darts/kEeB_UpGrAdE/media/useful_template.png

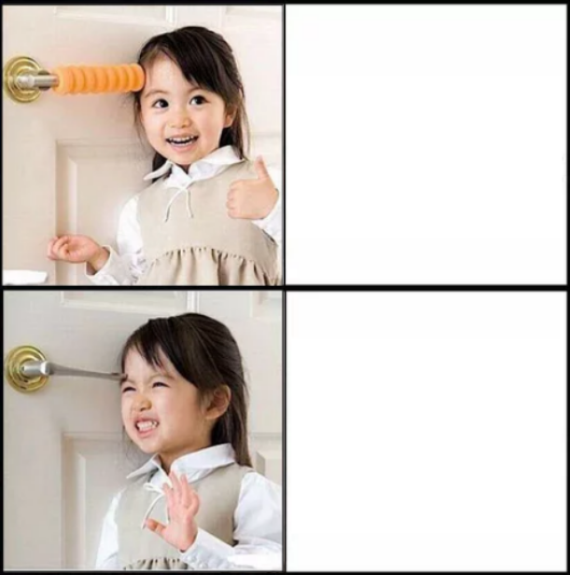
media/useful_template.png
