darts/kEeB_UpGrAdE/stl/kEeB_bOtToM.stl

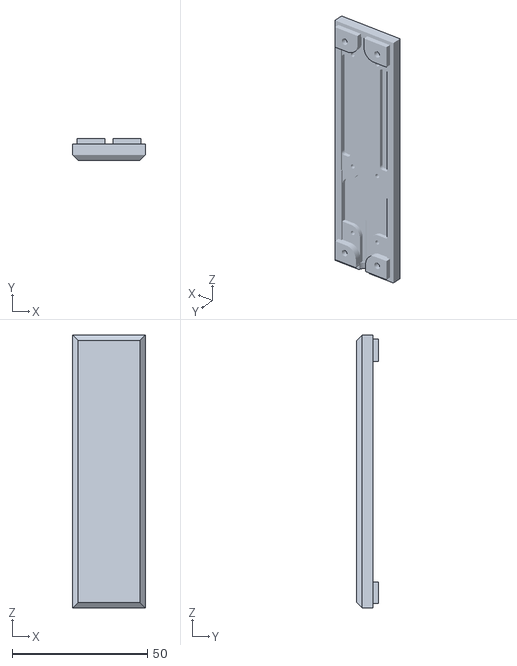
[picture p7: CAD file, 2023-09-17]
stl/kEeB_bOtToM.stl
27.0 x 8.00 x 101.0
