darts/kEeB_UpGrAdE/stl/kEeB_tOp.stl

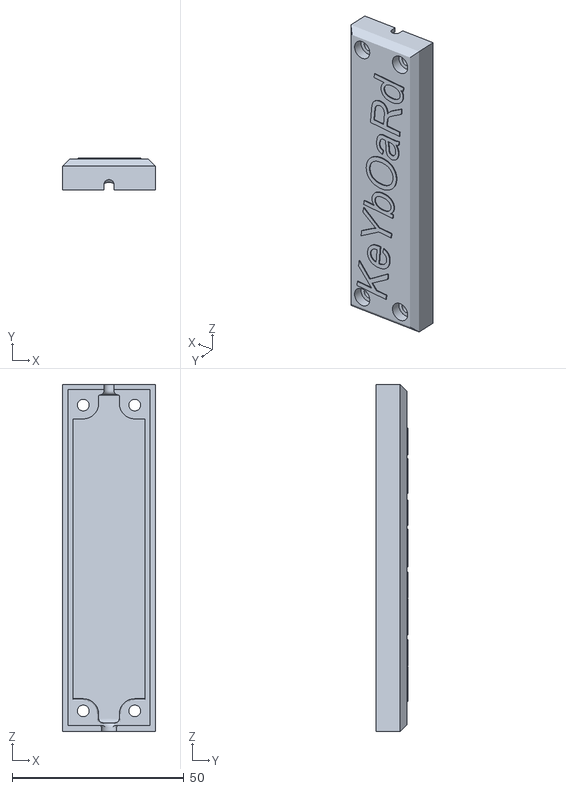
[picture p8: CAD file, 2023-09-17]
stl/kEeB_tOp.stl
27.0 x 9.30 x 101.0
